tudoraionut85-source/low-frequency-amplifier/README.md

# Low Frequency Voltage Amplifier Design

A professional hardware development project focused on the design, simulation, and physical implementation of a signal amplification module. This repository follows a complete engineering lifecycle, from theoretical design to manufacturing-ready documentation.

## Project Scope
The design implements a high-performance voltage amplifier optimized for low-frequency signals. The development process includes:
* **Schematic Design:** Full circuit capture and component selection using professional CAD tools.
* **Performance Verification:** Comprehensive simulations to ensure circuit stability and signal integrity.
* **PCB Engineering:** Optimized SMT layout designed for reliability and industrial manufacturing standards.

## Industry Standards & Compliance
To ensure professional-grade quality and manufacturability, the project adheres to the following industry standards:
* **IPC-2221A:** Generic Standard on Printed Board Design.
* **IPC-7527:** Requirements for Solder Paste Printing.
* **IPC-A-610:** Acceptability of Electronic Assemblies.

## Repository Structure
* **/Schematics**: Electrical diagrams and project files.
* **/Simulations**: Analysis results and performance verification.
* **/Layout**: Multi-layer PCB design files and manufacturing layers.
* **/Documentation**: Technical reports and block diagrams.
* **/Bill_of_Materials**: Detailed component list for production.

## Tools Used
* **Cadence OrCAD 17.2** (Capture & PCB Editor)
* **PSpice** (Simulation Engine)

---
*Developed as part of the Electronics Engineering curriculum, following professional hardware manufacturing workflows.*
