tudoraionut85-source/low-frequency-amplifier/(commit log)

2026-03-25 Initial commit: Low Frequency Amplifier design
    [1N4148.OLB, 1n4148.opj, Anexa_Iova_Alexandru_Grupa_431E.xls, BC807-25.OLB, BC817-25.OLB, BC846B.OLB, BC856B.OLB, BZX84C10.OLB]
2026-03-25 Clean up folder structure: move files to root
    [1N4148.OLB, 1n4148.opj, Anexa_Iova_Alexandru_Grupa_431E.xls, BC807-25.OLB, BC817-25.OLB, BC846B.OLB, BC856B.OLB, BZX84C10.OLB]
